MichaelGoberling/8051-Microprocessor-Board/Report/FullSizeRender (2).jpg

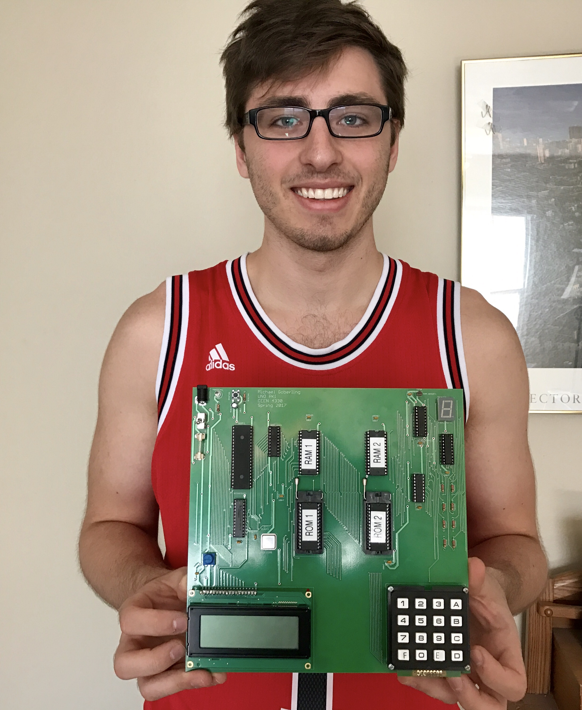
Report/FullSizeRender (2).jpg
