MichaelGoberling/8051-Microprocessor-Board/Report/IMG_2461.JPG

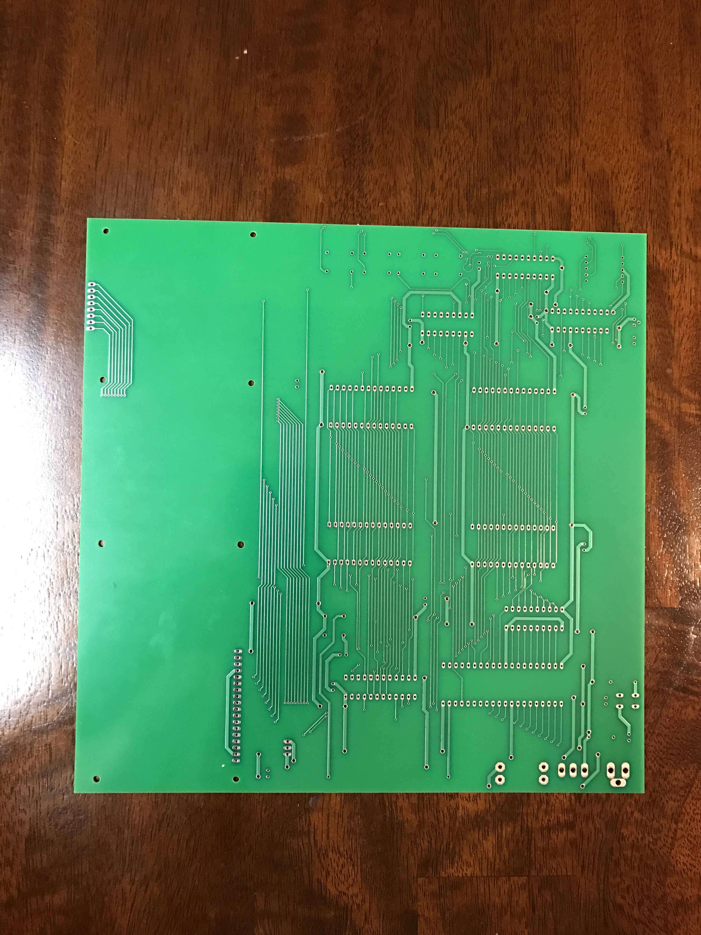
Report/IMG_2461.JPG
