MichaelGoberling/8051-Microprocessor-Board/3D 4330 PCB.PNG

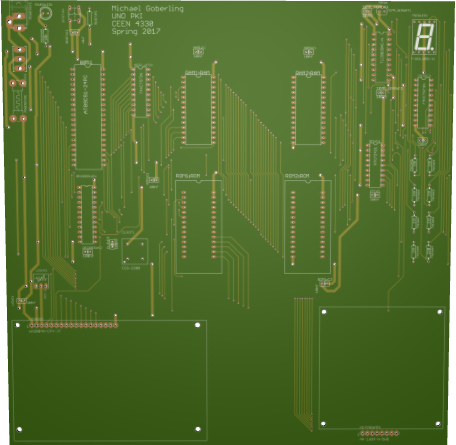
3D 4330 PCB.PNG
