MichaelGoberling/8051-Microprocessor-Board/Report/IMG_2462.JPG

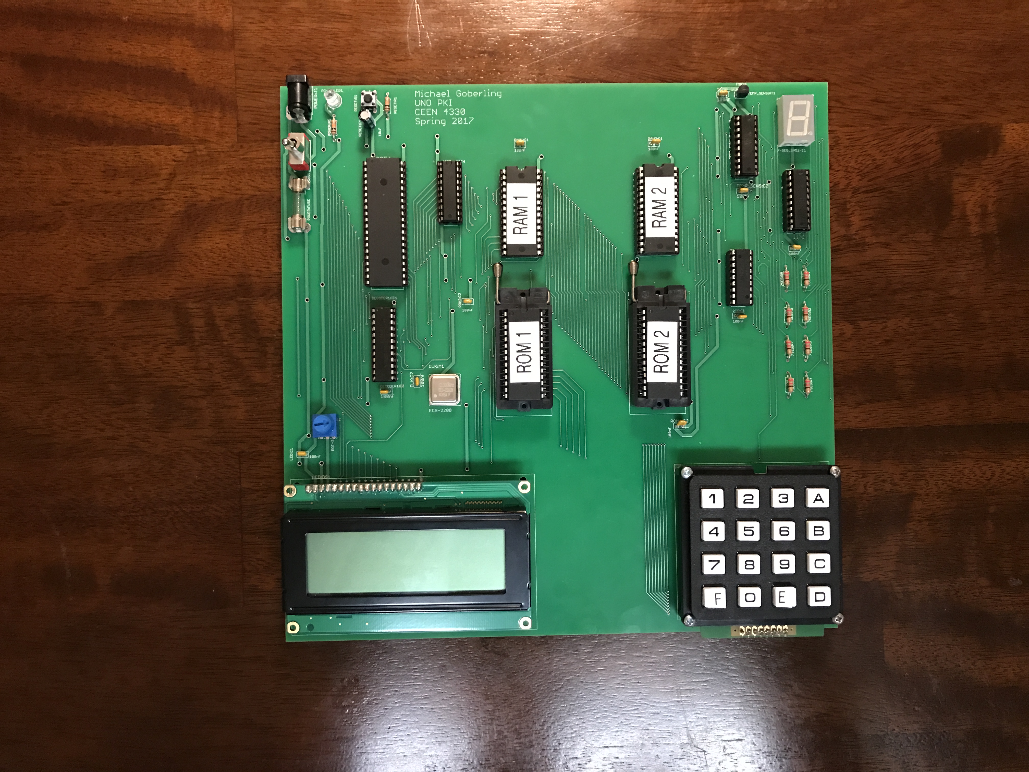
Report/IMG_2462.JPG
