MichaelGoberling/8051-Microprocessor-Board/Report/IMG_2463.JPG

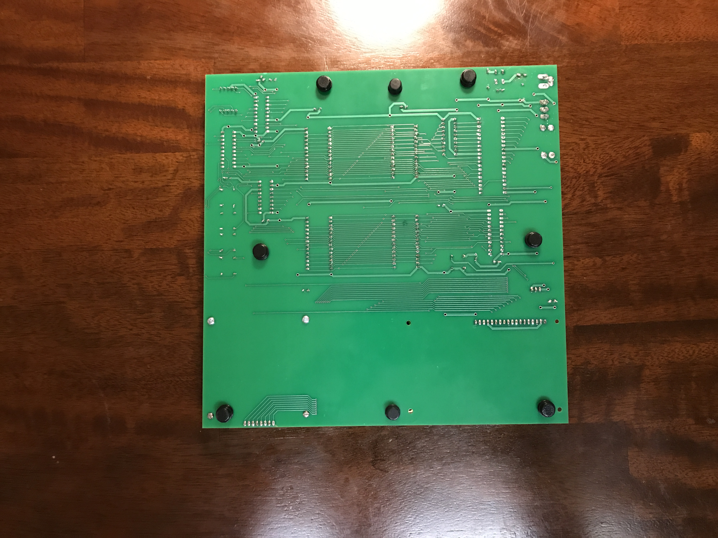
Report/IMG_2463.JPG
