MichaelGoberling/8051-Microprocessor-Board/Schematics/LCD/LCD-1.jpg

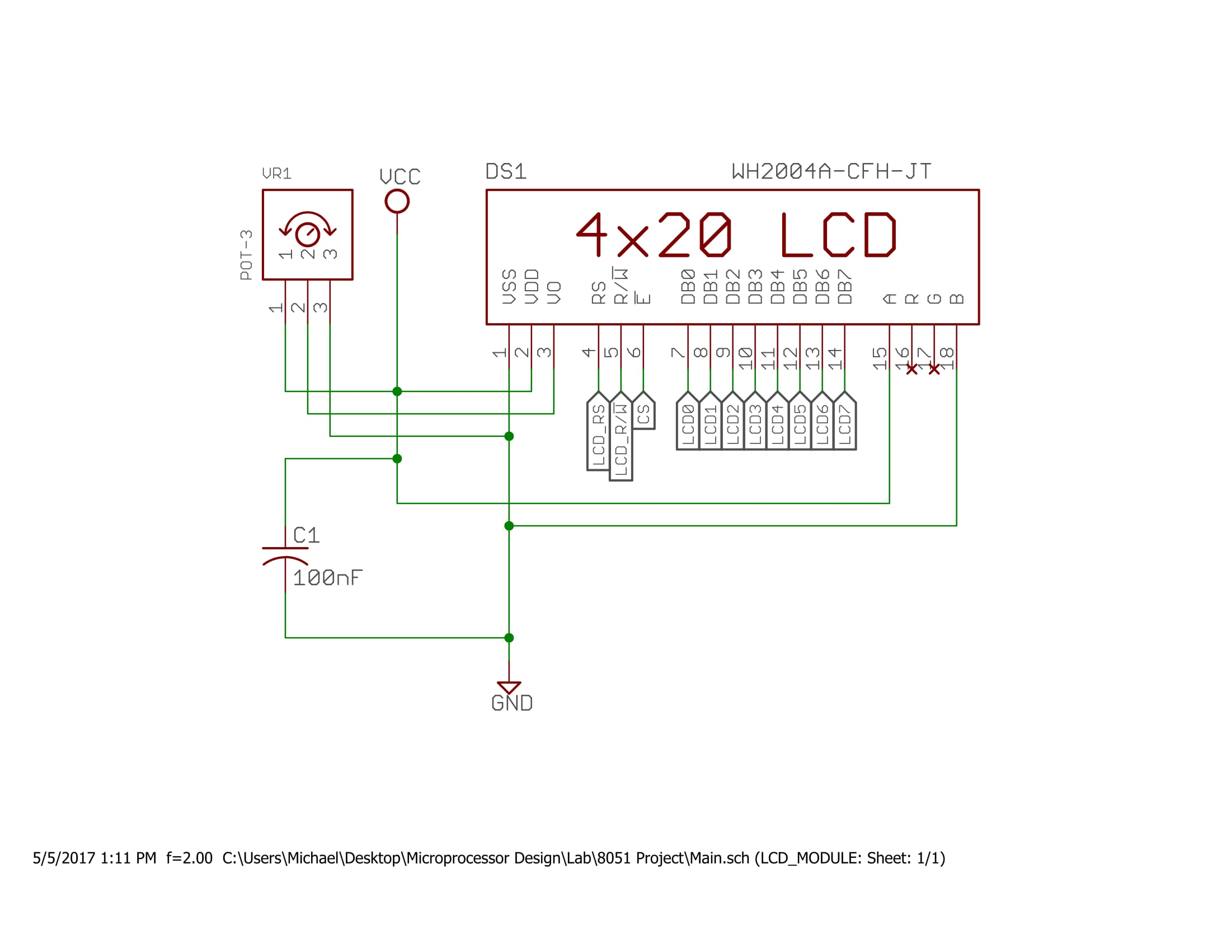
Schematics/LCD/LCD-1.jpg
