MichaelGoberling/8051-Microprocessor-Board/Schematics/Power.pdf

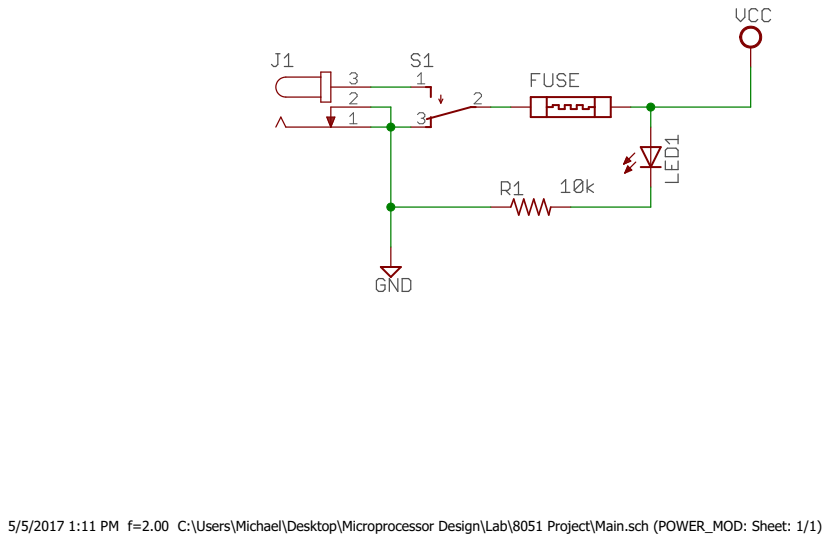
[picture p41: page 1]

5/5/2017 1:11 PM f=2.00 C:\Users\Michael\Desktop\Microprocessor Design\Lab\8051 Project\Main.sch (POWER_MOD: Sheet: 1/1)
