MichaelGoberling/8051-Microprocessor-Board/Schematics/ADC AND SENSOR.pdf

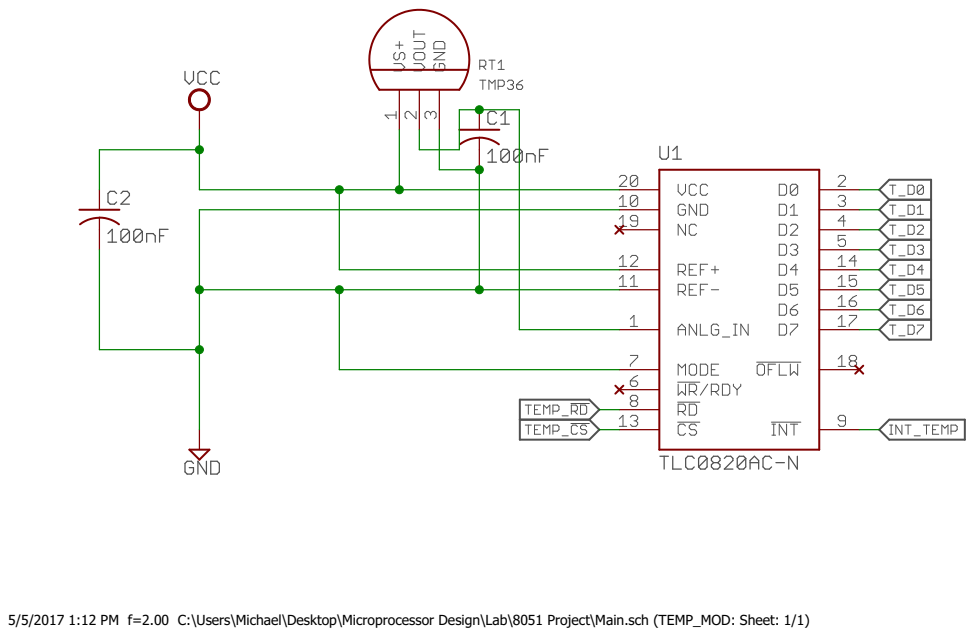
[picture p42: page 1]

5/5/2017 1:12 PM f=2.00 C:\Users\Michael\Desktop\Microprocessor Design\Lab\8051 Project\Main.sch (TEMP_MOD: Sheet: 1/1)
