MichaelGoberling/8051-Microprocessor-Board/Schematics/Main.pdf

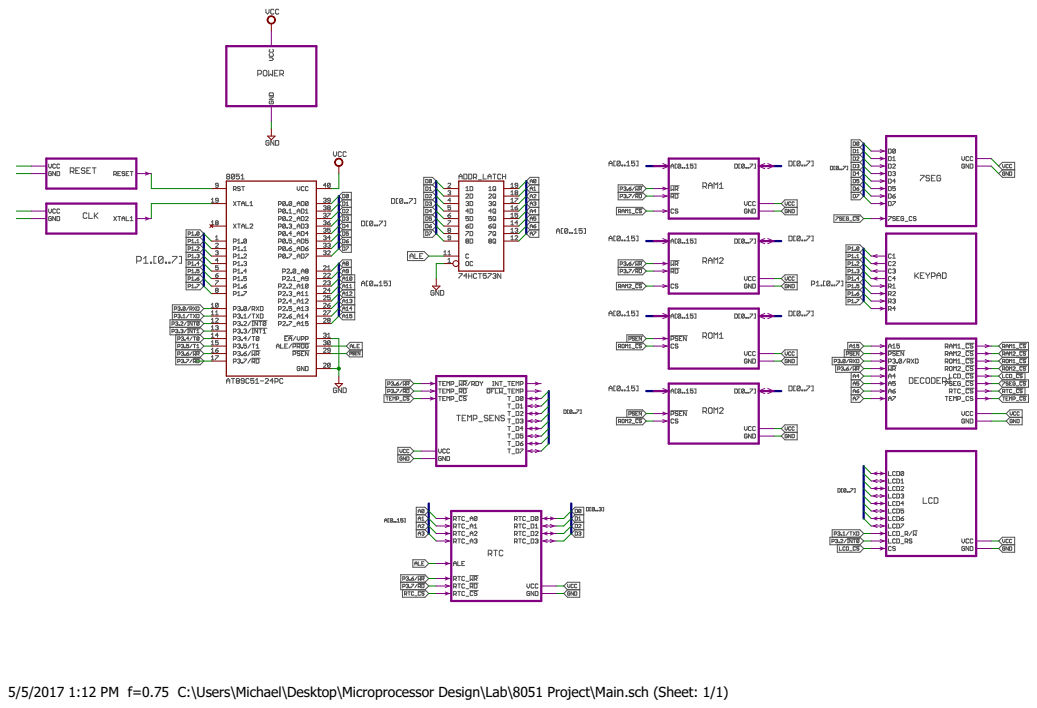
[picture p43: page 1]

5/5/2017 1:12 PM f=0.75 C:\Users\Michael\Desktop\Microprocessor Design\Lab\8051 Project\Main.sch (Sheet: 1/1)
