MichaelGoberling/8051-Microprocessor-Board/Schematics/RAM.pdf

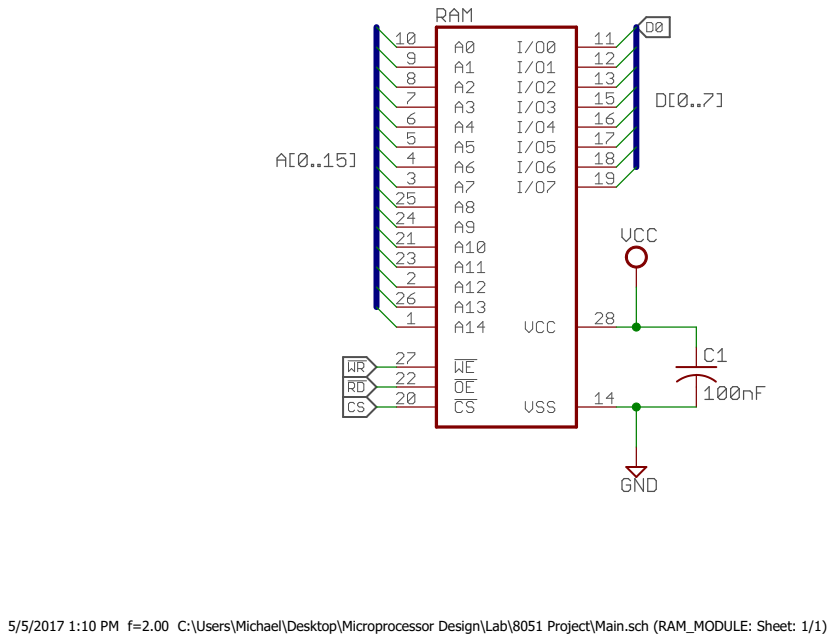
[picture p44: page 1]

5/5/2017 1:10 PM f=2.00 C:\Users\Michael\Desktop\Microprocessor Design\Lab\8051 Project\Main.sch (RAM_MODULE: Sheet: 1/1)
