MichaelGoberling/8051-Microprocessor-Board/Main.sch

## EAGLE design Main.sch (2018-03-01)

Schematic: Main.sch

Parts:
IC1: AT89C51-24PC; DIL40
IC2: 74HCT573N; DIL20
U$1: NC
