MichaelGoberling/8051-Microprocessor-Board/Report/IMG_2460.JPG

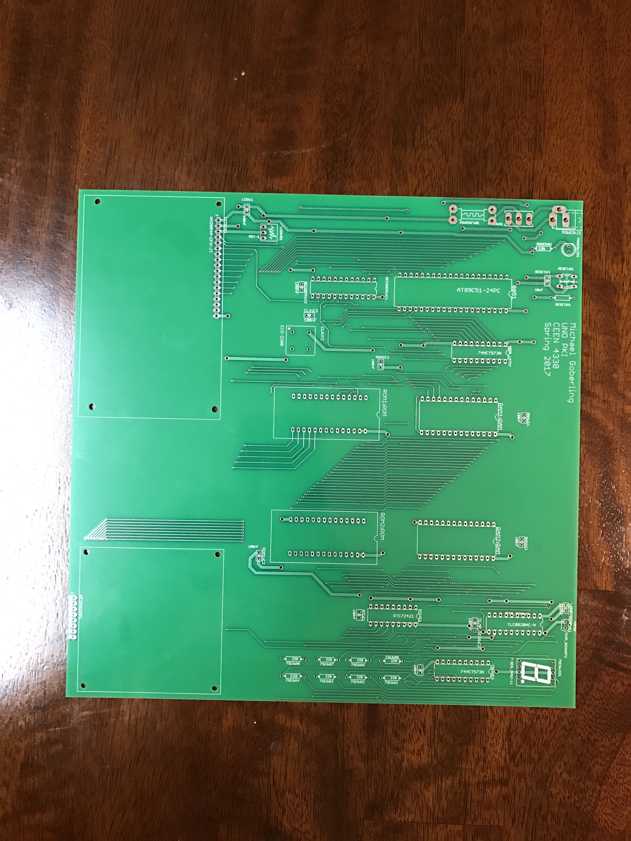
Report/IMG_2460.JPG
